vedderb/nunchuk_rf_hw/README.md

# nunchuk_rf_hw

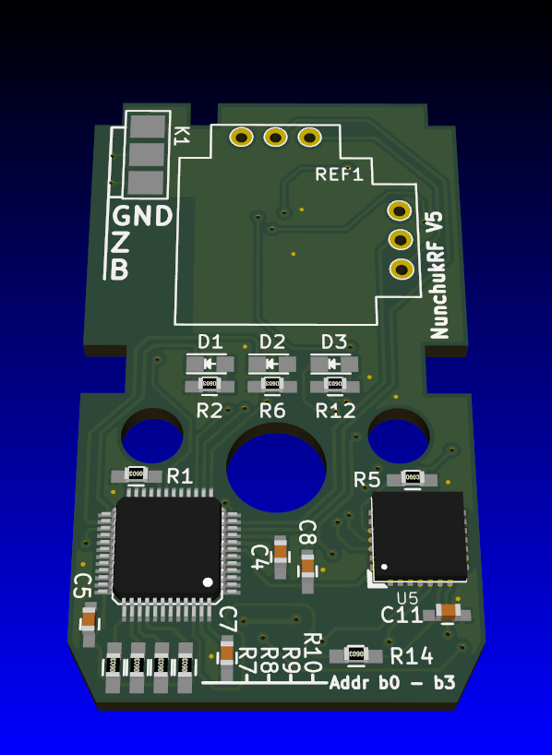
[picture p1: Plot/NunchukRF_V3_3d_front.png]

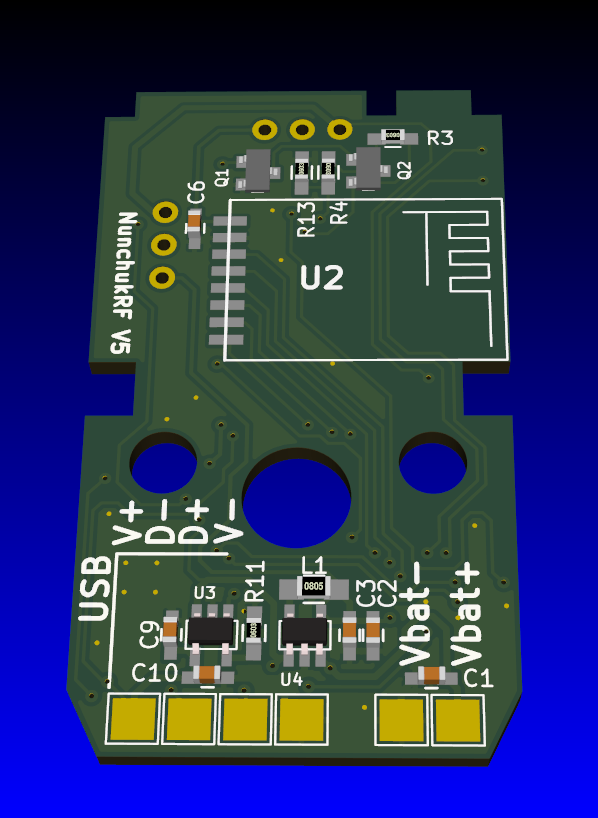
[picture p2: Plot/NunchukRF_V3_3d_back.png]
