vedderb/nunchuk_rf_hw/Plot/kicad_1.png

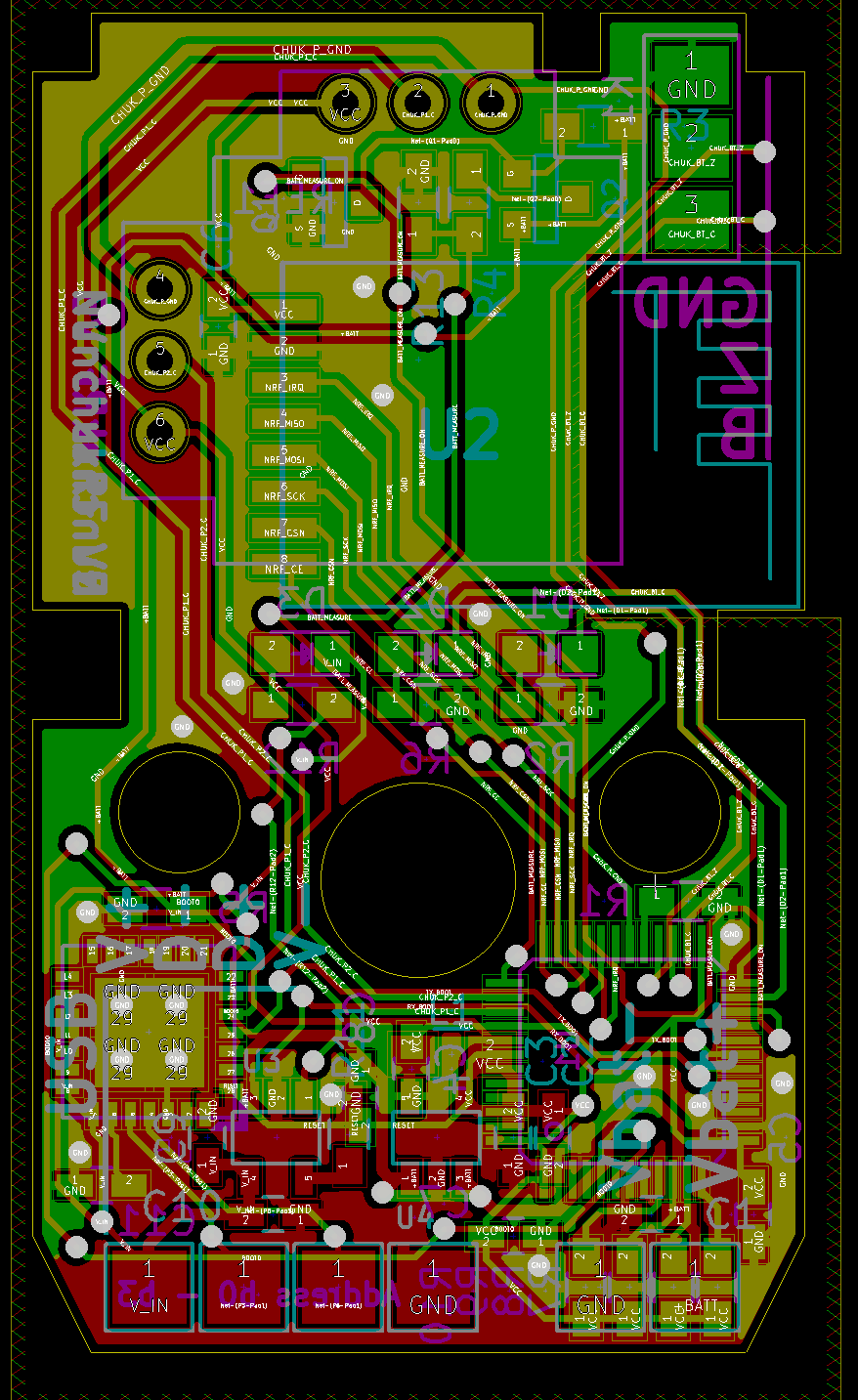
Plot/kicad_1.png
