vedderb/nunchuk_rf_hw/NunchukRF_V5_BOM.ods

Component Ref | Value | Part number | Quantity | Price 1 | Mouser Part Number | Mfg Name | Description | Min\Mult Order Qty
C1,C2,C9 | 10u/6.3V | C1608X5R0J106M080AB | 3 |  | 810-C1608X5R0J106M | TDK |  | 1\1
C3,C4,C5,C6,C7,C10,C11 | 2.2u/6.3v | C1608X5R0J225M080AB | 7 |  | 810-C1608X5R0J225M | TDK |  | 1\1
C8 | 100n | C1608X7R1H104K080AA | 1 |  | 810-C1608X7R1H104K | TDK |  | 1\1
L1 | 2.2uH | ELG-TEA2R2NA | 1 |  | 667-ELG-TEA2R2NA | Panasonic |  | 1\1
D1 | LED Green 0805 | LTST-C170KGKT | 1 |  | 859-LTST-C170KGKT | Lite-On |  | 1\1
D2 | LED RED 0805 | LTST-C170KRKT | 1 |  | 859-LTST-C170KRKT | Lite-On |  | 1\1
D3 | LED BLUE 0805 | LTST-C170TBKT | 1 |  | 859-LTST-C170TBKT | Lite-On |  | 1\1
R2,R6,R7,R8,R9,R10 | 1k | RK73H1JTTD1001F | 6 |  | 660-RK73H1JTTD1001F | KOA Speer |  | 1\1
R1,R5,R11,R11,R14 | 2k | RK73H1JTTD2001F | 5 |  | 660-RK73H1JTTD2001F | KOA Speer
R12 | 470 Ohms | RK73H1JTTD4700F | 1 |  | 660-RK73H1JTTD4700F | KOA Speer
R3,R4,R13 | 20k | RK73H1JTTD2002F | 3 |  | 660-RK73H1JTTD2002F | KOA Speer |  | 1\1
REF1 | CHUK_STICK | NR-010030 orders@supremefactory.com | 1
U1 | STM32F100C8T6B | STM32F100C8T6B | 1 |  | 511-STM32F100C8T6B | STMicroelectronics |  | 1\1
U2 | NRF24L01_SMD | Search on ebay for nrf24l01+ smd | 1 |  |  | Nordic Semiconductor |  | 1\1
U3 | MCP738131 | MCP73831T-2ACI/OT | 1 |  | 579-MCP73831T-2ACIOT | Microchip |  | 1\1
U4 | LM3671MF | LM3671MF-3.3/NOPB | 1 |  | 926-LM3671MF-3.3NOPB | Texas Instruments |  | 1\1
U5 | CP2102 | CP2102-GM | 1 |  | 634-CP2102-GM | Silicon Labs
Q1 | MOSFET N | BSS138LT1G | 1 |  | 863-BSS138LT1G | ON Semiconductor
Q2 | MOSFET P | BSS84 | 1 |  | 512-BSS84 | Fairchild Semiconductor
