vedderb/nunchuk_rf_hw/Plot/NunchukRF_V3.pdf

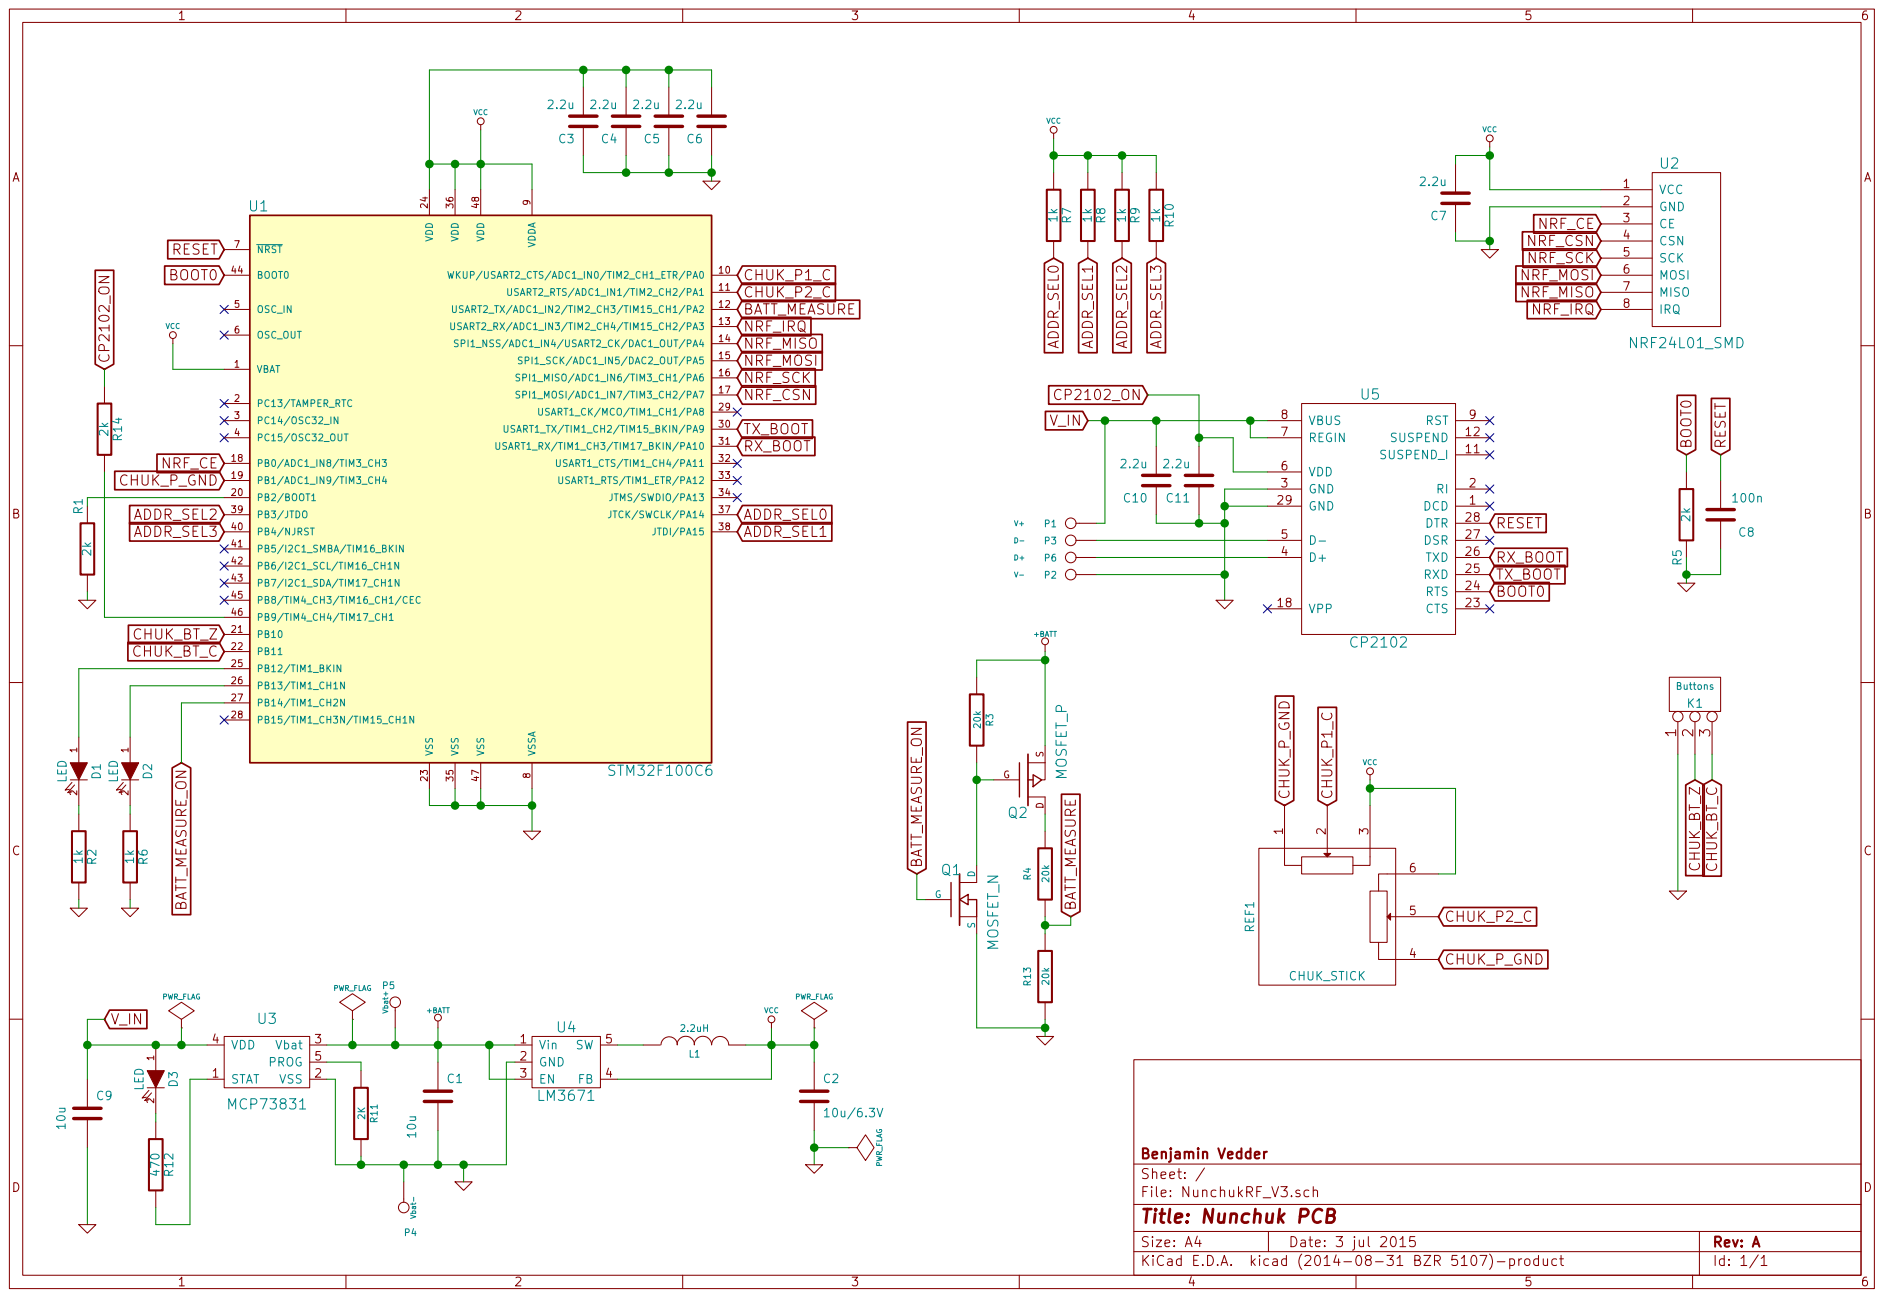
[picture p4: page 1]

9 WKUP/USART2_CTS/ADC1_IN0/TIM2_CH1_ETR/PA0 10 PB2/BOOT1 20 USART1_TX/TIM1_CH2/TIM15_BKIN/PA9 30 PB4/NJRST 40 USART2_RTS/ADC1_IN1/TIM2_CH2/PA1 11 PB10 21 USART1_RX/TIM1_CH3/TIM17_BKIN/PA10 31 PB5/I2C1_SMBA/TIM16_BKIN 41 USART2_TX/ADC1_IN2/TIM2_CH3/TIM15_CH1/PA2 12 PB11 22 USART1_CTS/TIM1_CH4/PA11 32 PB6/I2C1_SCL/TIM16_CH1N 42 USART2_RX/ADC1_IN3/TIM2_CH4/TIM15_CH2/PA3 13 VSS 23 USART1_RTS/TIM1_ETR/PA12 33 PB7/I2C1_SDA/TIM17_CH1N 43 SPI1_NSS/ADC1_IN4/USART2_CK/DAC1_OUT/PA4 14 VDD 24

File: NunchukRF_V3.sch Sheet: / Benjamin Vedder

Id: 1/1 Title: Nunchuk PCB
