vedderb/nunchuk_rf_hw/NunchukRF_V3.kicad_pcb

## KiCad design NunchukRF_V3.kicad_pcb (2015-10-19)

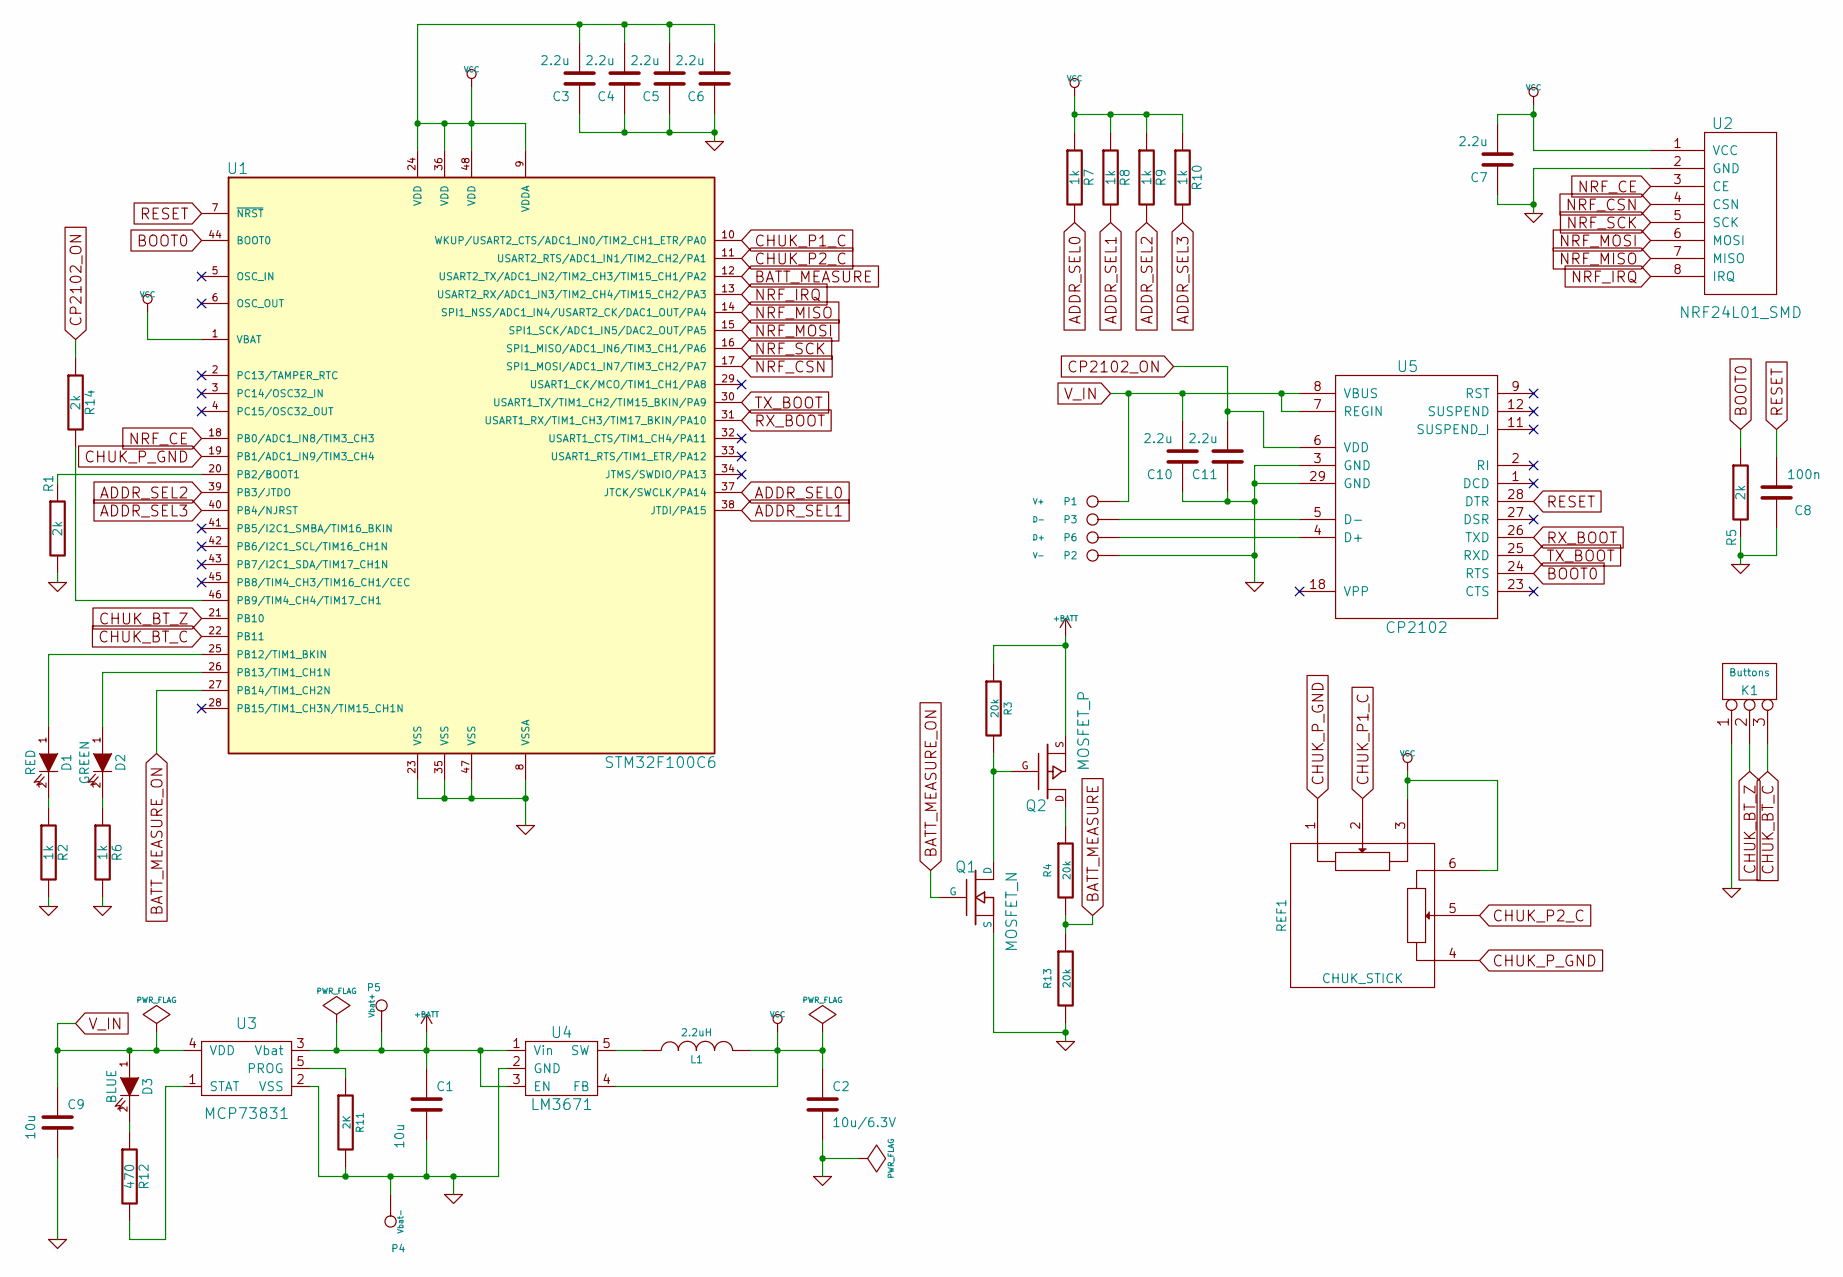
[picture p5: schematic NunchukRF_V3.sch, Nunchuk PCB]

Parts:
C1, C9: 10u; C_0603_HandSoldering
C2: 10u/6.3V; C_0603_HandSoldering
C3, C4, C5, C6, C7, C10, C11: 2.2u; C_0603_HandSoldering
C8: 100n; C_0603_HandSoldering
D1: RED; LED-0805
D2: GREEN; LED-0805
D3: BLUE; LED-0805
K1: Buttons; Wafer_Vertical10x5.8x7RM2.5-3
L1: 2.2uH; R_0805_HandSoldering
P1: V+; 1PAD_Small
P2: V-; 1PAD_Small
P3: D-; 1PAD_Small
P4: Vbat-; 1PAD_Small
P5: Vbat+; 1PAD_Small
P6: D+; 1PAD_Small
Q1: MOSFET_N; SOT23GDS
Q2: MOSFET_P; SOT23GDS
R1, R5, R14: 2k; R_0603_HandSoldering
R2, R6, R7, R8, R9, R10: 1k; R_0603_HandSoldering
R3, R4, R13: 20k; R_0603_HandSoldering
R11: 2K; R_0603_HandSoldering
R12: 470; R_0603_HandSoldering
REF1: CHUK_STICK; chuk_stick_2
U1: STM32F100C6; lqfp48_pad_mod
U2: NRF24L01_SMD
U3: MCP73831; SOT23-5
U4: LM3671; SOT23-5
U5: CP2102; QFN-28-1EP_5x5mm_Pitch0.5mm

Connections:
+BATT: C1.1, P5.1, Q2.S, R3.1, U3.3 (Vbat), U4.1 (Vin), U4.3 (EN)
ADDR_SEL0: R7.2, U1.37 (JTCK/SWCLK/PA14)
ADDR_SEL1: R8.2, U1.38 (JTDI/PA15)
ADDR_SEL2: R9.2, U1.39 (PB3/JTDO)
ADDR_SEL3: R10.2, U1.40 (PB4/NJRST)
BATT_MEASURE: R4.2, R13.1, U1.12 (USART2_TX/ADC1_IN2/TIM2_CH3/TIM15_CH1/P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)
BATT_MEASURE_ON: Q1.G, U1.27 (PB14/TIM1_CH2N)
BOOT0: R5.1, U1.44 (BOOT0), U5.24 (RTS)
CHUK_BT_C: K1.3, U1.22 (PB11)
CHUK_BT_Z: K1.2 (PM), U1.21 (PB10)
CHUK_P1_C: REF1.2 (P1_B), U1.10 (WKUP/USART2_CTS/ADC1_IN0/TIM2_CH1_ETR/P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)
CHUK_P2_C: REF1.5 (P2_B), U1.11 (USART2_RTS/ADC1_IN1/TIM2_CH2/PA1)
CHUK_P_GND: REF1.1 (P1_A), REF1.4 (P2_A), U1.19 (PB1/ADC1_IN9/TIM3_CH4)
CP2102_ON: C11.2, R14.1, U5.6 (VDD)
GND: C1.2, C2.2, C3.1, C4.1, C5.1, C6.1, C7.1, C8.1, C9.2, C10.1, C11.1, K1.1, P2.1, P4.1, Q1.S, R1.2, R2.2, R5.2, R6.2, R11.2, R13.2, U1.8 (VSSA), U1.23 (VSS), U1.35 (VSS), U1.47 (VSS), U2.2 (GND), U3.2 (VSS), U4.2 (GND), U5.3 (GND), U5.29 (GND)
NRF_CE: U1.18 (PB0/ADC1_IN8/TIM3_CH3), U2.3 (CE)
NRF_CSN: U1.17 (SPI1_MOSI/ADC1_IN7/TIM3_CH2/PA7), U2.4 (CSN)
NRF_IRQ: U1.13 (USART2_RX/ADC1_IN3/TIM2_CH4/TIM15_CH2/P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), U2.8 (IRQ)
NRF_MISO: U1.14 (SPI1_NSS/ADC1_IN4/USART2_CK/DAC1_OUT/PA4), U2.7 (MISO)
NRF_MOSI: U1.15 (SPI1_SCK/ADC1_IN5/DAC2_OUT/PA5), U2.6 (MOSI)
NRF_SCK: U1.16 (SPI1_MISO/ADC1_IN6/TIM3_CH1/PA6), U2.5 (SCK)
unnamed: D1.1 (A), U1.25 (PB12/TIM1_BKIN)
unnamed: D1.2 (K), R2.1
unnamed: D2.1 (A), U1.26 (PB13/TIM1_CH1N)
unnamed: D2.2 (K), R6.1
unnamed: D3.2 (K), R12.1
unnamed: L1.1, U4.5 (SW)
unnamed: P3.1, U5.5 (D-)
unnamed: P6.1, U5.4 (D+)
unnamed: Q1.D, Q2.G, R3.2
unnamed: Q2.D, R4.1
unnamed: R1.1, U1.20 (PB2/BOOT1)
unnamed: R11.1, U3.5 (PROG)
unnamed: R12.2, U3.1 (STAT)
unnamed: R14.2, U1.46 (PB9/TIM4_CH4/TIM17_CH1)
RESET: C8.2, U1.7 (~NRST), U5.28 (DTR)
RX_BOOT: U1.31 (USART1_RX/TIM1_CH3/TIM17_BKIN/PA10), U5.26 (TXD)
TX_BOOT: U1.30 (USART1_TX/TIM1_CH2/TIM15_BKIN/PA9), U5.25 (RXD)
VCC: C2.1, C3.2, C4.2, C5.2, C6.2, C7.2, L1.2, R7.1, R8.1, R9.1, R10.1, REF1.3 (P1_C), REF1.6 (P2_C), U1.1 (VBAT), U1.9 (VDDA), U1.24 (VDD), U1.36 (VDD), U1.48 (VDD), U2.1 (VCC), U4.4 (FB)
V_IN: C9.1, C10.2, D3.1 (A), P1.1, U3.4 (VDD), U5.7 (REGIN), U5.8 (VBUS)

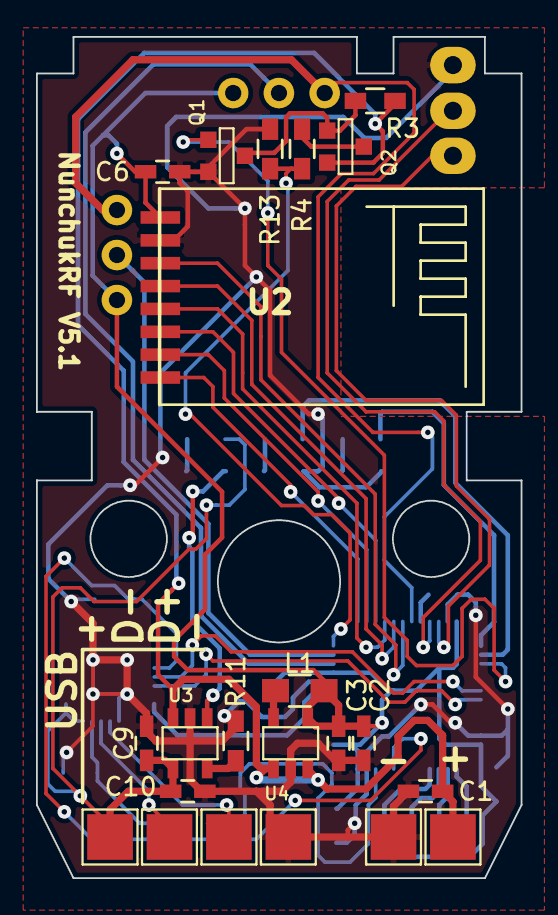
[picture p6: board NunchukRF_V3.kicad_pcb from above]

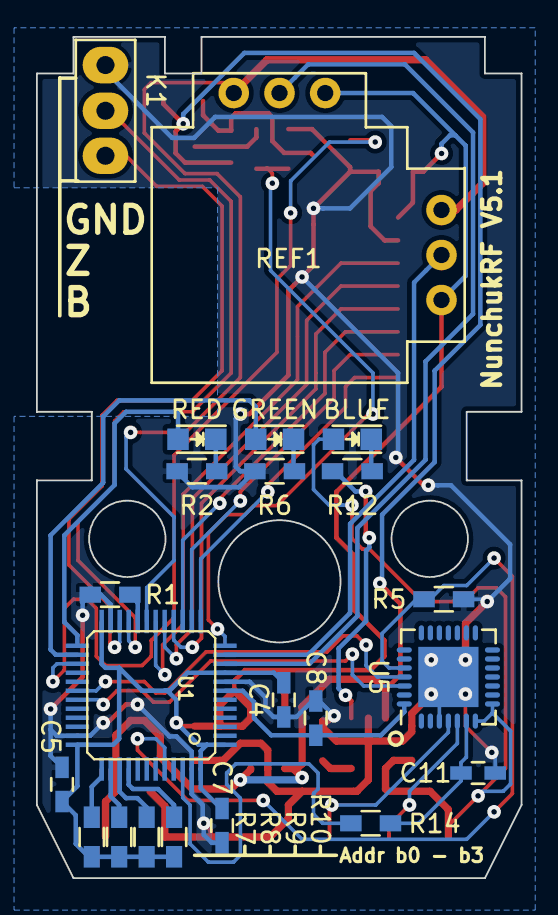
[picture p7: board NunchukRF_V3.kicad_pcb from below]

Board: 2 copper layers, 26.9 x 46.7 mm, 44 parts (22 on the bottom side), 40 nets.
