vedderb/nunchuk_rf_hw/(commit log)

2015-08-19 Added cp2102 power detect connection to mcu
    [NunchukRF_V3-B_Cu.gbl, NunchukRF_V3-B_Mask.gbs, NunchukRF_V3-B_SilkS.gbo, NunchukRF_V3-Edge_Cuts.gbr, NunchukRF_V3-F_Cu.gtl, NunchukRF_V3-F_Mask.gts, NunchukRF_V3-F_SilkS.gto, NunchukRF_V3.drl]
2015-08-20 Updated NRF labels
    [NunchukRF_V3.kicad_pcb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]
2015-08-20 Updated BOM
    [NunchukRF_V5_BOM.ods]
2015-08-23 Updated 3d pictures and saved using the latest kicad version
    [NunchukRF_V3.kicad_pcb, NunchukRF_V3.sch]
2015-08-31 Changed CP2102 footprint
    [NunchukRF_V3-B_Cu.gbl, NunchukRF_V3-B_Mask.gbs, NunchukRF_V3-B_SilkS.gbo, NunchukRF_V3-Edge_Cuts.gm1, NunchukRF_V3-F_Cu.gtl, NunchukRF_V3-F_Mask.gts, NunchukRF_V3-F_SilkS.gto, NunchukRF_V3.drl]
2015-09-17 Small update
    [NunchukRF_V3.kicad_pcb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]
2015-10-19 Moved nrf, changed button connector, updated labels
    [NunchukRF_V3-B_Cu.gbl, NunchukRF_V3-B_Mask.gbs, NunchukRF_V3-B_SilkS.gbo, NunchukRF_V3-Edge_Cuts.gm1, NunchukRF_V3-F_Cu.gtl, NunchukRF_V3-F_Mask.gts, NunchukRF_V3-F_SilkS.gto, NunchukRF_V3.drl]
